badaunicoleta/Single-Stage_Industrial_Gearbox/Project_Documetation.pdf

TECHNICAL UNIVERSITY OF CLUJ-NAPOCA

FACULTY OF AUTOMOTIVE, MECHATRONICS AND MECHANICAL ENGINEERING

DEPARTMENT OF MECHATRONICS AND MACHINE DYNAMICS

# SEMESTER PROJECT

## SINGLE-STAGE INDUSTRIAL GEARBOX

at

## ELEMENTS OF MECHANICAL ENGINEERING

## Sem. II, Year 2020-2021

## Scientific supervisor:

Ciprian-Radu RAD, Ph.D.

## Student Name: Bădău Elena Nicoleta

## Group Number: 30322

Bădău Elena Nicoleta

## Contents

3.1.2 Pitch line velocity (derived from angular velocity and radius of the spoor gear)........11

EME End-of-Semester Project

## Chapter 1. Introduction

### 1.1 Project theme

Design a single stage speed reducer gearbox based on a spur gear (an elementary gearing) that can be used for an industrial mixer. The conceptual design of the mechanical power transmission is presented in Fig. 1.1. It consists of a three-phase induction motor (1), a single stage spur gear reducer (2), two coupling element (3) and the industrial process (4). The material used for the gears is OLC 45 quality carbon steel and for the shafts OL 50 carbon steel. Each student will use their given input data to design the mechanical power transmission.

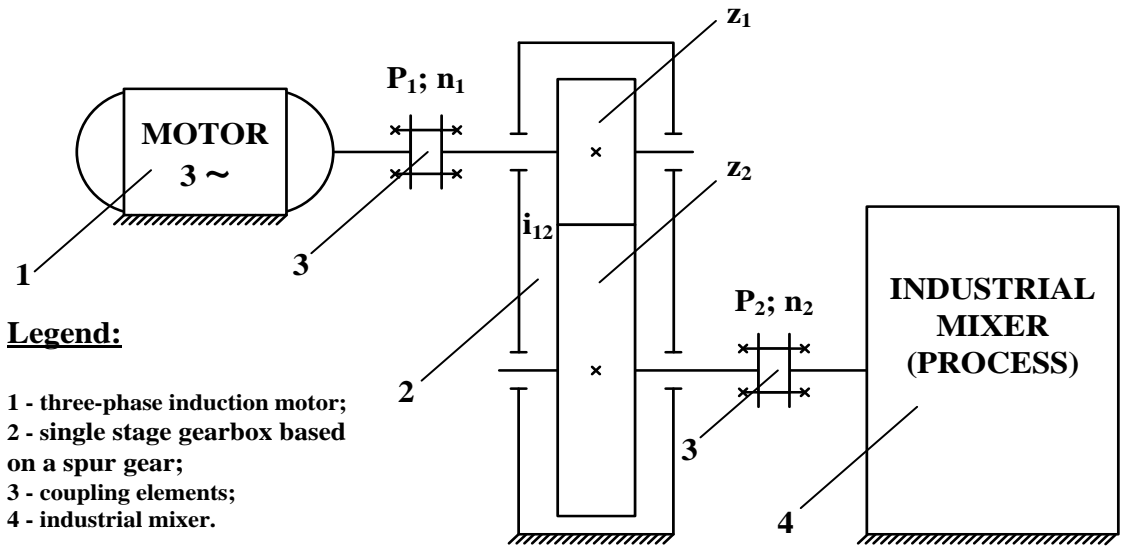
[picture p1: figure]
MOTOR 3 ~; INDUSTRIAL MIXER; (PROCESS); P2; n2 Legend:

Fig. 1.1. Kinematic diagram of the mechanical power transmission.

1 - three-phase induction motor; 2 - single stage gearbox based on a spur gear; 3 - coupling elements; 4 - industrial mixer.

### Input data:

### n = 1 student number

P2

### = 10.4 [kW] – output power

ns

### = 1500 [RPM] – synchronous speed of the motor

i

### 12 = 2.6 (transmission ratio)

z

1 | = 25 (number of teeth of the input gear)
Lh | = 20000 [hours] - number of running hours

### 1.2 Gear speed reducers

Gear speed reducers are mechanical devices used to reduce the speed of an actuator (usually engines) safely and efficiently. They are present in various mechanisms like: cars, bikes (every vehicle which has a gearbox), industrial and household machineries and also they are an object of interest regarding the research in the robotics and mechatronics which almost certainly will, if they have not already, become most important engineering fields of research.
Depending on how they are implemented there are several categories of speed reducers: Parallel axis gear speed reducer, Bevel gear speed reducer, Hypoid speed reducer, Worm speed Reducer and Helical Speed Reducer depending on their structure, on the elements that composed the speed reducer such as: helical gears, spur gears, bevel gears, worm gear and wheels ( for more detail about them check [9], some of them are also detailed in 1.3).
Gear speed reducers are part of transmission systems which are vital in any vehicles powered by engines and they have the role to transmit and adapt the power of the engine to the drive wheels. They are also widely used in municipal waterworks, locks, and flood control systems. They are extremely important and we interact with them very often without even noticing.
The transmissions and speed reducers are devices that obtained the required rotational speed. However, they have one or more important role. That is that they obtain a rotational force (torque) proportional to the deceleration ratio. For example, if we have the rotational speed, that rotational force (torque) will double. This is because the mechanism of changing and decelerating speed uses the principle of leverage (Ex. [9]).

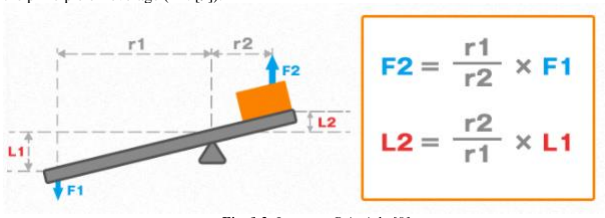
[picture p2: figure]

Fig. 1.2. Leverage Principle [9]

The above figure(see Fig.1.2) shows the principle of leverage. The formula in the above figure demonstrates that a large force called F2 can be obtained with the force of F1 (Ex. [9]), noticing the same procedure for transmission( see Fig.1.3).

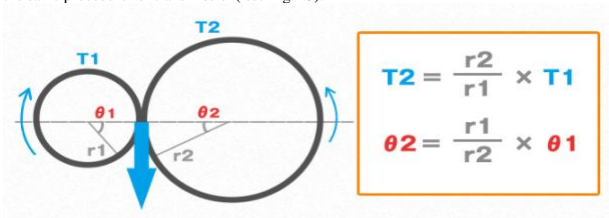
[picture p3: figure]

Fig. 1.3. Rotating Body [9]

Historically, the first ideas of speed reducers and the concept of gearboxes belonged to Muslim polymath named Ismail al-Jazari. In his book called “The Book of Knowledge of Ingenious Mechanical Devices” he talked about arrangements of wheels and mechanical devices, automatic controls, valves and another mechanisms and concepts we study today in engineering. After a long break of 6 centuries, the concept of speed reducer was mentioned again by a British manufacturing and engineering company called Watt & Boulton Engine which designed a gearbox featuring two gears and a rotational speed governor in 1817. Later in 1904, the Sturtevant brothers invented what they called a “horseless carriage gearbox”, which was actually an early automatic power transmission speed reducer.
During the first part of 20 century, the manufacturers were focusing on developing speed reducers for automotive industry, but with the evolution of technology, they become an integrated part of many applications, they are produced in a wide range of sizes and they are constantly improved in terms of: precision, energy efficiency, versatility and many others. For extra details check [10], [11].
The production process is pretty complex and it can be divided in three main parts: making the gears and shafts using cutting and forming processes, creating the gear housings which have to protect the gears against corrosion and another types of contamination and finally the assembling process which brings everything into one functional mechanism which will look like in figure 1.4 (see Fig.1.4). The most common materials used in manufacturing speed reducers are steel (higher or lower quality), plastic and sometimes even wood.

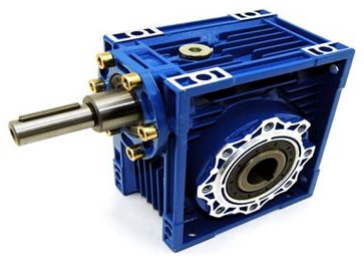
[picture p4: figure]

Fig. 1.4 Gear speed reducer [12]

An important aspect to point out as a conclusion is that, if you are an engineer or maybe you are just a student which has a project to do for university and you want to buy a speed reducer, you have to take a very close look at specifications before sending the order. The most important specifications are the one related to environment, operating conditions and motor type. For more details check [13], where you will find out also what risks are if the specifications and rules made by the manufacturer are not respected.

### 1.3 Power transmission design analysis and justification

Some of the most known and spread mechanical devices worldwide, met in most of the mechanisms that we see every day (cars, industrial machines, household items, robots, and even bikes) are speed reducers and speed amplifiers. When building a speed reducer, the first thing needed is an interdisciplinary team with experience in this domain, a team which is able to analyze and design according to the project requirements a speed reducer which is optimal when considering the following criteria: safety of the people which interact with the mechanism, cost (not too high to be unaffordable but not so low that it can damage the quality of the product by using poor materials), size, reliability and low noise.
In order to be able to quantify a technical solution according to these criteria we need to take a closer look to the possible designs which can be used to implement such a device. Four possible solutions could be: belt drive design, chain drive design, single-stage gear-reducer design and belt drive with single-stage gear-reducer design (for a closer look to technical drawings and performances of each design check [8]) .
The design chosen for our device is single-stage gear-reducer because it has some important features like the high level of safety for operators, the rotating components being enclosed. Another important advantage is the high reliability due to the fact that precision metallic parts are used in a sealed housing(to prevent the contaminating of the metal), belts and chains are also good but they are usually more expensive and their design may also include more moving parts which is seen as a possible risk of failure. The maintenance cost and size are expected to be reduced because of design’s relative simple implementation.
Another possible alternative could be the belt drive with single-stage gear-reducer design because using it we could provide a variable speed operation which could be useful for our application (industrial mixer). Varying the speed of the mixer is possible by using different belt drive ratio. Nevertheless, we can vary speed using our single-stage gear-reducer too, by using a variable speed electric drive motor.
Having the design, we need to focus on what type of gear-type reducer to use. Here are some possible types we can use (for more details check [8]):
Single-reduction spur gears, with high efficiency (> 95%), only radial loads are met so the selection of bearings is significantly simplified and spur gears are relatively cheap to produce. Also shafts position would be parallel, easy to align with the motor and the drive shaft for the mixer.
Single-reduction helical gears, similar with single-reduction spur gears which come to some advantages like smaller size of the mechanism and also some disadvantages like the apparition of axial thrust loads which will cause changes in bearings selection and in housing mechanism. Bevel gears, more difficult to design and assemble.
Worm and wormgear drive present many disadvantages like: lower efficiency, heat generation and the need of a stronger engine.
Considering all these facts, the final decision is single-reduction spur gear reducer design because it works well for our industrial mixer application and the costs are likely to be the lowest.

## Chapter 2. Selecting the Actuator

### 2.1 Selecting the AC motor

### 2.1.1 Synchronous speed calculation

ns =

60×f
p
[RPM] ns = 1500[RPM] | (1)

where:
f = motor supply’s frequency in hertz p = number of pairs of magnetic poles

### 2.1.2 Calculate the slip

s =

ns−nn
ns

=

1500−1440
1500
= 0,04 = 4% = slip | (2)
wℎere s − slip, ns − syncℎronous speed [RPM], nn − rotor nominal speed [RPM] nn < ns

### 2.1.3 Calculate the required motor power [kW] = Pm (needed to transmit P2)

Actuator power
Pm =

P2
η

[kW] =

10.4
0.93
= 11.18[kW], P2 = 10.4[kW] | (3)
wℎere Pm − required motor power [kW] P2 − output power [kW]
η − mecℎanical transmission efficiency

Mechanical transmission efficiency η = ηg × ηb

2 × ηl
= 0.96 × (0.99)
2 × 0.99 = 0.93 − Mecℎanical transmission efficiency | (4)
wℎere ηg − spur gear efficiency = 0.96 ÷ 0.98
ηb − one pair of bearings efficiency = 0.99 ÷ 0.995 ηl − lubrication efficiency = 0.99

! The systems which use spur gears are efficient (η > 0.9)

### 2.1.4 The required values – > The AC motor values (we choose the right engine Pm < Pn)

Pm = 11.18[kW] ns = 1500[RPM] => Pn = 15[kW] nn = 1440[RPM] | (5)

I choose the ASU 160L-4 AC motor with the following properties:
Pn = 15 kW − nominal power of tℎe motor
nn = 1440 − rotor nominal speed[RPM] < ns = 1500[RPM]
η = 0,90 = 90% − mecℎanical transmission efficiency

### 2.1.5 The AC engine dimensions

(see Fig.2.1)

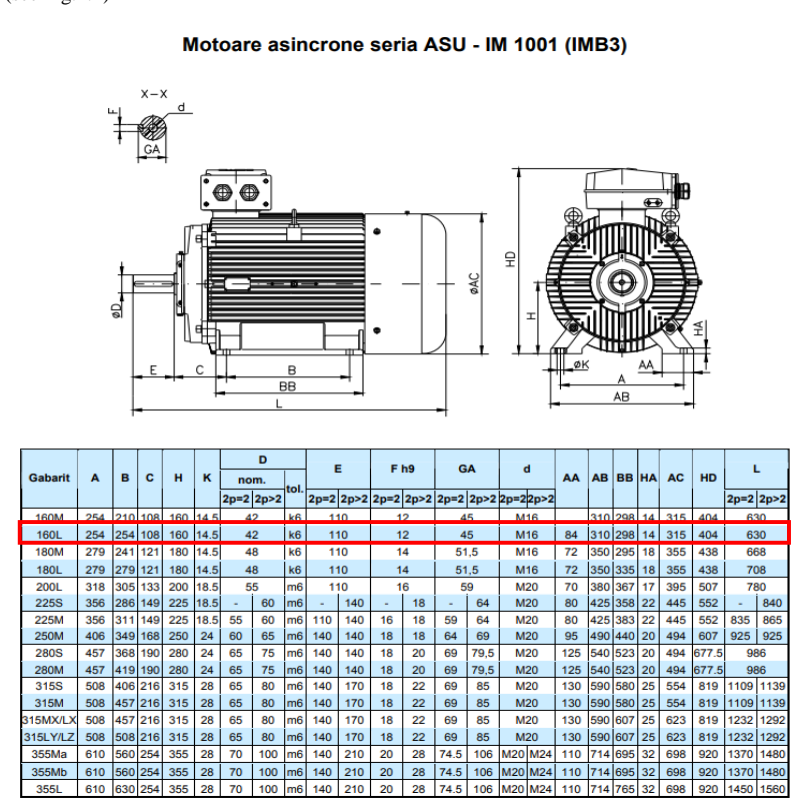
[picture p5: figure]

Fig. 2.1.ASU 160L-4 AC motor dimensions [1]

### 2.2 Power transmission kinematics

### 2.2.1 Determining the number of teeth of the output gear

z2 = i12 × z1 = 2.6 × 25 = 65 − number of teetℎ for tℎe second gear(output gear) (6) wℎere i12 − transmission ratio
z1 − number of teetℎ for tℎe first gear(input gear)
−if z2 is a wℎole number u12 = i12 = 2.6 − transmission ratio
−tℎerefore,tℎe real transmission ratio u12 witℎ tℎe new z2 value can be calculated as(Ex.[2]): u12 =

z2
z1

=

65
25
= 2.6 | (7)
−in tℎis situation tℎe following condition must be meet(Ex.[2]): −2.5% ≤

u12−i12
i12

≤ +2.5% → εu12 = ±2.5% is ok, because u12will be used furtℎer! (8)

### 2.2.2 The Input/Output shaft speed

n1 = nn

[RPM] => n1 = 1440[RPM] → Input (engine speed) | (9)
n2 =

n1
i12

=

1440
2.6

[RPM] = 553.84[RPM] → Output , wℎere i12 − transmission ratio (10)

### 2.2.3 Power transmitted by input shaft

P1 = Pm[kW] → P1 = 11.18[kW] − Power transmitted by sℎaft 1(engine power) (11)

### 2.2.4 The Input/Output shaft Torque

T1 = 95500 ×

P1
n1
= 741.45[daN ∗ cm] | (12)

T2 = 95500 ×

P2
n2
= 1793.29[daN ∗ cm] | (13)

## Chapter 3. Spur Gear Design

### 3.1 Gear tooth strength analysis and verification

### 3.1.1 Strategy

Size the spur gears according to contact stress and then check if the dimensions obtained respects the bending stress conditions too. We will use as material OLC45 high quality steel.

### 3.1.2 Pitch line velocity (derived from angular velocity and radius of the spoor gear)

Pinion peripheral speed or pitch line velocity is associated with angular velocity and radius of the spoor gear.

v = 0.1 × √n1
2 ×

P1
u12

4
= 5.87[m⁄s] | (14)
wℎere P1 = 11.18 × 1.34 = 14.98 HP(HorsePower) | (15)
P1 − transmitted power in ℎorse power [HP] (1kW = 1.34HP)
n1 − Input (engine speed)
u12 − transmission ratio

### 3.1.3 Equivalent load

k = kc × kd = 1.2 → Load factor,
wℎere: kc − load distribution factor, kc = 1 ÷ 1.22
kd − load dynamic factor, kd = 1.2 | (16)

The dynamic load factor was chosen considering: precision class, angular velocity, tooth shape and Hardness Brinell using the catalog from [3] table 9.2.

We use OLC45 with NB=197 ≤350(HB-Hardness Brinell)

### 3.1.4 Equivalent torque

Te1 = k × T1 = 889.74[daN ∗ cm] | (17)

### 3.1.5 Contact stress (dimensioning central/axial distance A)

ψA =

A
B

= 0.4 (medium speed reducer),
ψA − axial coefficient of tℎe gear, ψA = 0.3 ÷ 0.6 | (18)

σak = 26 × HB = 26 × 197 = 5122[daN/cm²
] (for OLC 45) | (19)
wℎere αak − allowable contact stress
HB − Hardness Brinell according to table from [3]table 9.4.

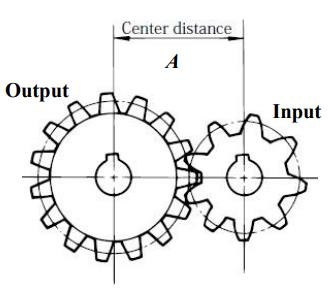
[picture p6: figure]

Fig. 3.1. Axial distance A [3]

Axial distance A(see Fig. 3.1) influences directly the contact stress, using α(pressure angle) = 20°
(see Fig.3.2)
Amin = (u12 + 1) × √
Te1
ψA×u12×sin2α

× (

865

σak

)

3 | 2
[cm] = 10.76[cm] = 107.6[mm] | (20)

α = 20°
Fig. 3.2. Tooth Shape [3]

Aw(standardized) = 108[mm] cℎoosing a rounded value > Amin

### 3.1.6 Circular pitch module(m)

- the distance between 2 successive teeth (must be equal for both spur gears)

z1 = 25 → number of teetℎ for tℎe first gear
z2 = z1 × i12 = 25 × 2.6 = 65 teetℎ
→ number of teetℎ for tℎe second gear (using relation (6))

mmin =

2Aw
z1+z2

cosα
cosα0
[mm], wℎere α0 = 20° → mmin = 2.4[mm] | (21)

m ≥ mmin
m(standardized) = 2.5 mm → A cℎanges!

A =

m×(z1+z2)
2

=

2.5×(25+65)
2
= 112.5[mm] → Final axial distance | (22)

### 3.1.7 Modular coefficient of the gear

ψm =

A×ψA
m
= 18 ε(8, 40), wℎere ψA = 0.4 − axial coefficient of tℎe gear | (23)

### 3.1.8 Bending stress (verification)

{
σ =

2Te1
π×m³×z1×ψm×Cf×cosα0

≤ σai [

daN
cm²

] → σ =

2×889.74
3.14×(0.25)³×25×18×0.1355×0.94

= 661.51 [

daN
cm²

]

mb = √
0.68×Te1
z1×ψm×Cf×σai

3

≤ m [mm] → mb = √
0.68×889.74
25×18×0.1355×1327.16

3
= 0.19[cm] ≤ m = 0.25[cm]

(24)

### 3.1.9 Allowable bending stress

σai =

σ0
kσ×C

=

4300
1.8×1.8

= 1327.16 [

daN
cm²
] | (25)

wℎere kσ − stress concentration coefficient, kσ = 1.2 ÷ 2 C − safety coefficient, C = 1.5 ÷ 2

For additional information check [3] table 4.1.
σ ≤ σai → Verification successful!

mb ≤ m → Verification successful!

### 3.2 Final geometrical elements of the gears

### 3.2.1 Geometrical elements of the gears

The diameters of pitch circles
Dd1 = m × z1 = 2.5 × 25 = 62.5 [mm] | (26)
Dd2 = m × z2 = 2.5 × 65 = 162.5 [mm] | (27)

The diameters of outside circles
De1 = 2Re1 = m(z1 + 2 × f0
) = 2.5(25 + 2) = 2.5 × 27 = 67.5[mm] | (28)
De2 = 2Re2 = m(z2 + 2 × f0
) = 2.5(65 + 2) = 2.5 × 67 = 167.5[mm] | (29)

Whole depth
ℎ = m(2f0 + ω0
) = 2,5(2 + 0.25) = 2.5 × 2.25 = 5.62[mm] | (30)

The diameters of root circles Di1 = 2Ri1 = m(z1 − 2f0 − 2ω0

) = 2.5(25 − 2 − 2 × 0.25) = 56.25[mm] | (31)
Di2 = 2Ri2 = m(z2 − 2f0 − 2ω0
) = 2.5(65 − 2 − 2 × 0.25) = 156.25[mm] | (32)

wℎere f0 = 1 − reference ℎead ℎeigℎt, ω0 = 0.25 − reference foot ℎeigℎt

Gear face width
B = A × ψA = 45[mm] | (33)

Output gear (round up the obtained value)
B2 = A × ψA = 45[mm] | (34)

Input gear (round up the obtained value)
B1 = B2 + m = 47.5[mm] | (35)

### 3.2.2 Contact ratio

The radii of the base circles of the two gears Rb1 = Rd1

cosα0 =

m×z1
2
cosα0 = 29.37[mm] | (36)
Rb2 = Rd2

cosα0 =

m×z2
2
cosα0 = 76.37[mm] | (37)

ε =

√Re1
2 −Rb1

2 +√Re2
2 −Rb2

2 −A×sinα

π×m×cosα0

= 1.72 > 1.2 → works OK! | (38)

### 3.2.3 Span measurement

For z1 = 25 → n1 = 3(number of teetℎ between 18 − 26) N1 = z1 ×

α0
180° + 0.5 = 3.27 | (39)

Ln1 = m[(N1 − 0.5)π + z1inv α0

]cos α0 = 21.24 [mm] | (40)

For z2 = 65 → n2 = 8(number of teetℎ between 72 − 80)

N2 = z2 ×

α0
180° + 0.5 = 7.72 | (41)
Ln2 = m[(N2 − 0.5)π + z2inv α0
]cos α0 = 55.41 [mm] | (42)

wℎere inv α0 = inv 20° = 0.014904

## Chapter 4. Output Shaft Design

Shafts are subjected to torsion and bending stress! (see Fig. 4.1)

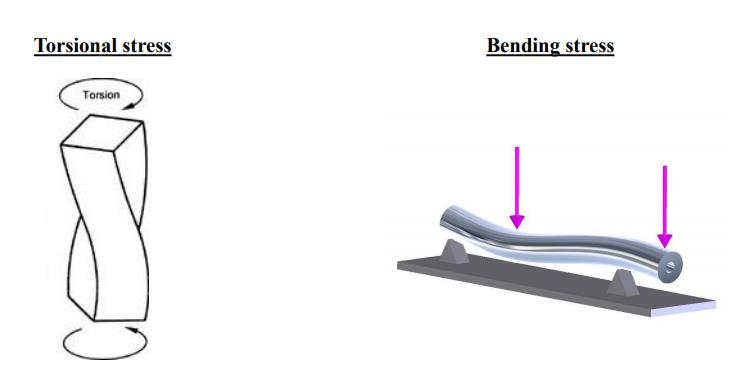
[picture p7: figure]

Fig. 4.1. Torsion and Bending stress [4]

### 4.1 Pre-dimensioning

### 4.1.1 Preliminary diameter

Preliminary diameter dp is determined at torsional stress because at this point the length of the shaft is not known.(Ex.[4])
dp min = √
16×T2
π×τat

3
[cm] = 3.93[cm] = 39.3[mm] | (43)

wℎere τat = 120 ÷ 250[daN/cm² ] − Torsional sℎear stress

dp ≥ dpmin

→ dp = 40[mm] − preliminary diameter | (44)

### 4.1.2 Preliminary length of the output shaft

b = B2

[mm] = 45[mm](face widtℎ) − tℎe widtℎ of tℎe second (output)gear | (45)
l = b + 2l1 + l2 = 45 + 20 + 20 = 85[mm] | (46)
wℎere l1 = 10[mm] l2 = 0.5 × dp = 20[mm]
particular lengtℎs wℎicℎ must be considered. For more details cℎeck [4]

### 4.1.3 Forces acting on a spur gear mesh

η ≈ 1 (Mechanical transmission efficiency)

Ft1 ≈ Ft2 (Tangential forces)

Fr1 ≈ Fr2 (Radial forces)

The spur gears mechanism is efficient in transmitting tangential and radial forces.
The forces occur between 2 teeth on a specific line as can be seen in the picture. (see Fig.4.2)

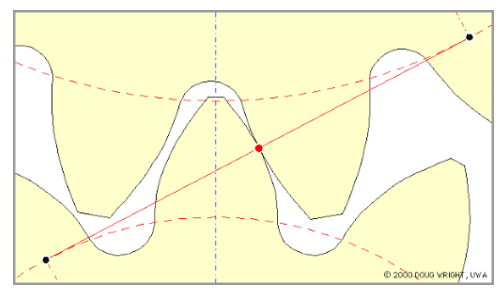
[picture p8: figure]

Fig. 4.2. Where forces act [4]

### 4.1.4 Tangential force (acts on vertical plane, on point number 6)

Dd2 = m × z2 = 2.5 × 65 = 162.5 [mm] − pitch diameter (using relation (25))

Ft2 =

2T2

Dd2

[daN] = 220.71[daN] | (47)

### 4.1.5 Radial force (acts on horizontal plane)

Fr2 = Ft2

tanα0

[daN] = 220.71 × 0.363 = 80.11[daN] | (48)
wℎere α0 = 20°

### 4.2 Shaft loading diagram

### (see Fig.4.3)

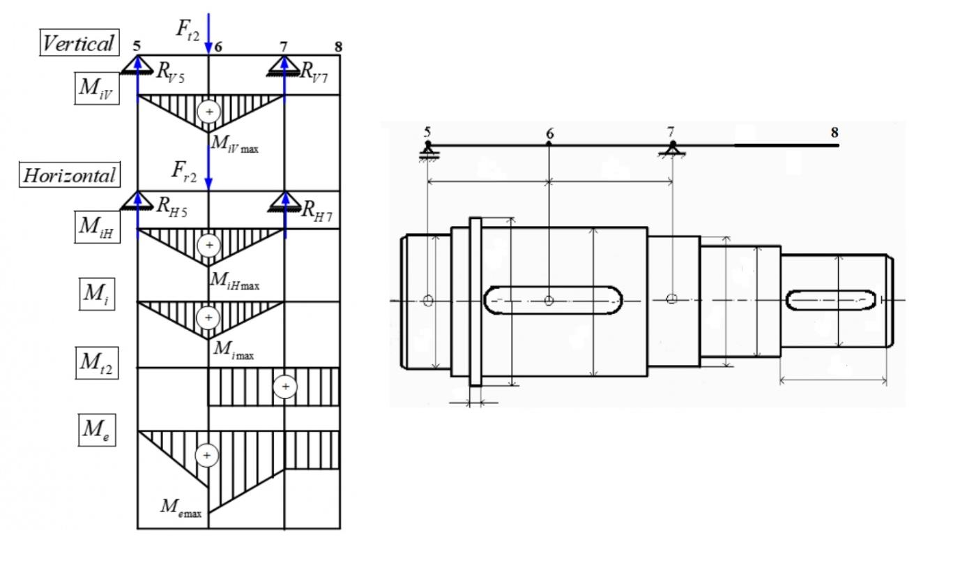
[picture p9: figure]

Fig. 4.3. Shaft loading diagram [4]

### 4.2.1 Reaction forces and bending moments in both planes

Vertical plane

RV5 = RV7 =

Ft2
2

[daN] =

220.71
2

= 110.35 [daN] −reaction forces on support points (5,7) (49)

MiVmax =

1
4

∗ Ft2 ∗ l [daN ∗ cm] = 234.49[daN ∗ cm] − maximum momentum produced by
the tangential force on vertical plane. | (50)

Horizontal plane

RH5 = RH7 =

Fr2
2

[daN] =

80.11
2

= 40.05[daN] −reaction forces on support points (5,7) (51)

MiHmax =

1
4

∗ Fr2 ∗ l [daN ∗ cm] = 170.23[daN ∗ cm] −maximum momentum produced by
the radial force on horizontal plane. | (52)

Resulting reaction forces (algebraic sum of the forces acting on horizontal/vertical plane)
R5 = R7 = √RV5
2 + RH5

2
[daN] = √13781.12 = 117.39[daN]

Resulting bending momentum (algebraic sum of the momentums acting on horizontal/vertical plane)

Mimax = √MiVmax
2 + MiHmax

2
[daN ∗ cm] = 289.76 [daN ∗ cm] | (53)

### 4.2.2 Equivalent bending moment

Memax = √Mimax
2 + (αT2
)
2 [daN ∗ cm] = 1114.3[daN ∗ cm] | (54)

wℎere T2 = 1793.29[daN ∗ cm] − output sℎaft torque (using relation (13))

α =

σaiΙΙΙ

σaiΙΙ

= 0.6 (OL50 build material) → Build material coefficient σaiΙΙΙ = 450 [daN/cm²

] σaiΙΙ = 750 [daN/cm²
]

### 4.2.3 Required diameter in critical section

dmin = √
32∗Memax

π∗σaiΙΙΙ

3
[cm] = 2.93[cm] | (55)

! Because a key will be used to assembly the gear with the shaft, the value of dmin must be increased by 4% (Ex.[4])

dmin = dmin + 4% ∗ dmin = 30.47 mm, round up tℎe result to final d = 32 mm (56)
d ≥ dmin

### 4.3 Final geometry of the shaft

(see Fig.4.4)

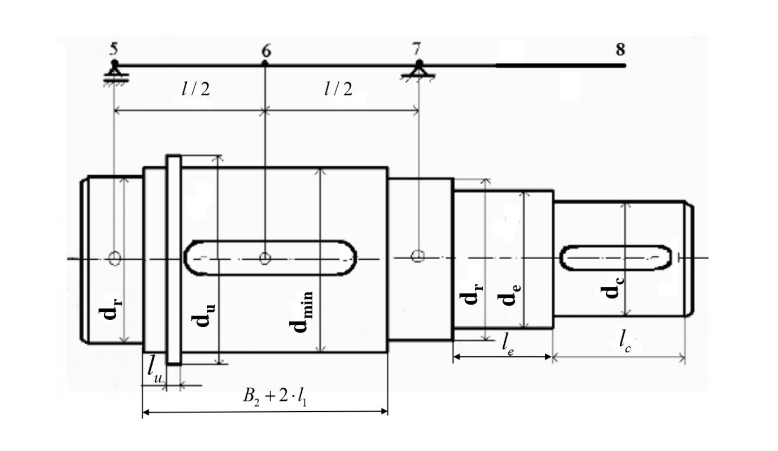
[picture p10: figure]

Fig. 4.4. Final geometry of the shaft [4]

Diameters in other points on the shaft

du > d > dr ≥ de > dc
du − is tℎe sℎoulder diameter (to be cℎosen)
d − is tℎe diameter wℎere tℎe output gear will be mounted(calculated before)
dr − is tℎe diameter of tℎe sℎaft wℎere tℎe bearings will be mounted (to be cℎosen) de − is tℎe diameter of tℎe sℎaft wℎere tℎe seal will be mounted(to be cℎosen)
dc − is the diameter of the end of the shaft; end of the shaft will be connected
to the process, in this case the industrial mixer through a coupling element (to be chosen). (Ex.[4])

### 4.3.1 Diameter of the end shaft (point 8)

dc min = √
16×T2
π×τat

3
[cm] = 2.33[cm] = 23.3[mm] | (57)

Torsional shear stress for OL 50 τat = (0.6 ÷ 0.65)σall [

daN
cm²

] = 0.6 × 1200 = 720 [

daN
cm²
] | (58)

σall = 1200 [

daN
cm²

]

wℎere σall

is tℎe allowable stress at traction for material OL 50, pulsating cycle, case II. (Ex.[4])

Choose a final value of diameter dc and then the length lc
from the next slide(Ex.[4])
dc ≥ dc min → dc = 24[mm] | (59)

### 4.3.2 Length of the end of the shaft

if dc = 24[mm] → lc = 50[mm] | (60)

### 4.3.3 Seal diameter

de = dc + (3. .5)mm = 24 + 3 = 27[mm] | (61)
le = 0.5 × dp = 0.5 × 40 = 20[mm] | (62)
wℎere dp = 40[mm] | (using relation (44))

### 4.3.4 Bearings diameter

dr = de + (3. .5)mm = 27 + 3 = 30[mm] | (63)

### 4.3.5 Shoulder diameter and length

du = d + (3. .5)mm = 32 + 3 = 35[mm] | (64)
lu = 4[mm] | (65)

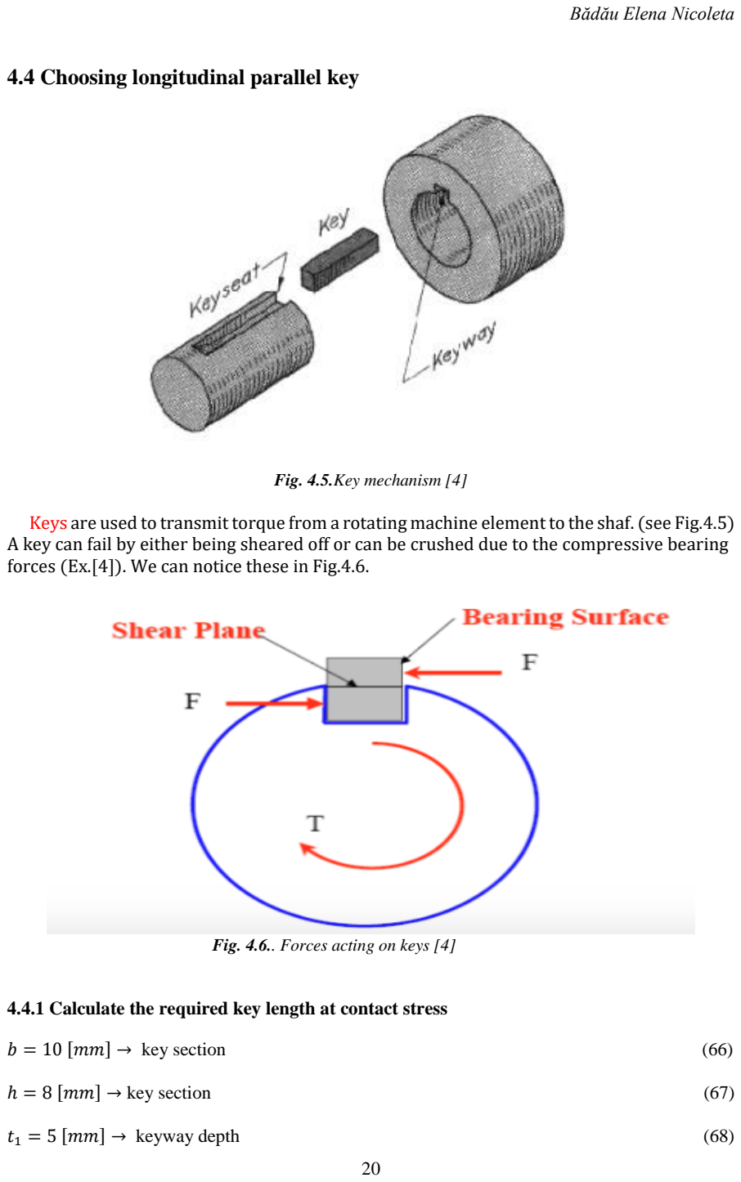
[picture p11: page 20]

### 4.4 Choosing longitudinal parallel key

Fig. 4.5.Key mechanism [4]

Keys are used to transmit torque from a rotating machine element to the shaf. (see Fig.4.5) A key can fail by either being sheared off or can be crushed due to the compressive bearing forces (Ex.[4]). We can notice these in Fig.4.6.

Fig. 4.6.. Forces acting on keys [4]

### 4.4.1 Calculate the required key length at contact stress

b = 10 [mm] → key section | (66)
ℎ = 8 [mm] → key section | (67)
t1 = 5 [mm] → keyway depth | (68)

t2 = 3.3 [mm] → keyway depth | (69)

We can see b, ℎ, t1,t2 in Fig.4.7.

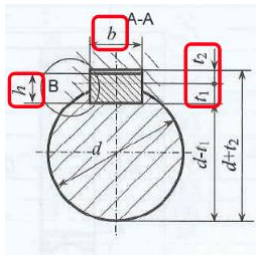
[picture p12: figure]

Fig.4.7. Key dimensions [4]

lmin =

4T2
ℎ×d×pa
[cm] = 3.5 [cm] = 35 mm − key minimum length | (70)

where pa = 800 [

daN
cm²

] −contact pressure

! The final length of the key must be correlated with the width B2 of the output gear. (Ex.[4]) lp = 0.8 × B2 = 0.8 × 45 = 36[mm] ≥ lmin = 35[mm] and is between (22,110)
(accepted lengths for 30 < d ≤ 38). I will use the standardized value lpa = 40[mm] | (71)
wℎere lpa ≥ lp

### 4.4.2 Verification for shear stress (already dimensioned for contact pressure)

τf =

2T2
b×d×lpa

< τaf [

daN
cm²

] → τf =

2×1793.29
1×3.2×4

= 280.2[daN/cm²
] < τaf | (72)
τaf = 960[daN/cm²
] − OL50

wℎere b = 1[cm](13), d = 3.2[cm](66), lpa = 4[cm](56), T2 = 1793.29[daN ∗ cm](64)

### 4.5 Verification of shaft deflection and critical speed

### 4.5.1 Deflection in vertical plane

fV =

Ft2∗l

3

48∗E∗I

[cm] = 261.60 × 10⁻⁶
[cm] | (73)

where:
E = 2.1 ∗ 10⁶

[daN/cm²
]
I = π ∗

d

4

64

[cm] = 5.14 [cm] | (74)
l=8.5 [cm] − the shaft length | (using relation (42))

### 4.5.2 Deflection in horizontal plane

fH =

Fr2∗l

3

48∗E∗I

[cm] = 94.95 × 10⁻⁶
[cm] | (75)

where:
E = 2.1 ∗ 10⁶

[daN/cm²
]
I = π ∗

d

4

64

[cm] = 5.14 [cm] | (using relation (67))
l=8.5 [cm] − the shaft length | (using relation (42))

### 4.5.3 Final deflection and admitted deflection

f = √fV
2 + fH

2 < fadm [cm] → f = 278.29 × 10⁻⁶ [cm] = 0.00027829[cm] < fadm [cm] (76)
fadm = 5 × 10⁻³ × m = 3 × 10⁻⁴ × l [cm] = 0.00255[cm] | (77)

### 4.5.4 Weight of the output gear + static deflection (check vibrations)

{
G = γ × V = γ ×

π×Dd

2

4

× B2

[daN] = 7.2[daN] − weight of the output gear

γ = 7.8 × 10⁻³

[

daN
cm³

]

(78)

### 4.5.5 Static deflection

{

fst =

G∗l

3

48∗E∗I

[cm] =

7.2×(8.5)

3
48×2.1×10⁶×5.14

= 8.53 × 10⁻³
[cm]

E = 2.1 × 10⁶

[

daN
cm²

]

I = π ×

d

4

64

[cm] = 5.14[cm]

(79)

### 4.5.6 Critical speed

ncr =

30
π

∗ √
g

fst

[RPM] = 102 376 [RPM] | (80)

g = 981 [

cm
s

2

] − gravitational acceleration

n2 = 553.84[RPM] < ncr (from relation (7))

## Chapter 5. Rolling Bearing Selection

### 5.1 Calculate dynamic basic bearing load rating C

### 5.1.1 Introduction – General facts

The ball bearings place in our design (see Fig.5.1):

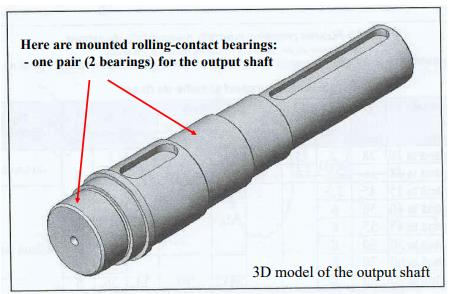
[picture p13: figure]

Fig. 5.1. Bearings location [5]

Important features:

Bearings are not designed, they are chosen accordingly to the project that you are working on from catalogues.

Another important feature of bearings is that they are consumables and are replaced periodically.

They need to be changed in pairs, both at the same time, in order to have the same characteristics and the same performances at a certain moment of time.

Considering our project, we will choose bearings which are built to support purely radial load (type A Fig. 5.2) because all our forces are acting perpendicular on the shaft.

Type of rolling-contact bearings:

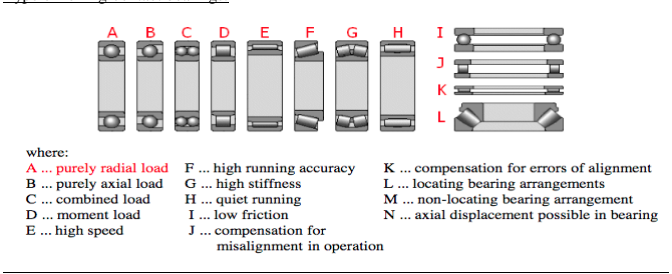
[picture p14: figure]

Fig. 5.2. Bearings types [6]

Cause of early bearings failure (see Fig. 5.3):

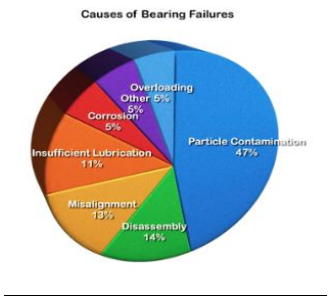
[picture p15: figure]

Fig. 5.3. Bearings location [6]

### 5.1.2 Fundamental calculation

We will use: Life’s equation (Lundberg & Palmgren) where:

C - dynamic basic bearing load rating [daN], calculated so that the bearings can support the load C for 1 million rotations.

L - the basic life measurable in millions of rotations

L =

60×n2×Lℎ
10⁶
[milions of rotations] = 664.6 [milions of rotations] | (81)

L = (

C
F

)

p
| (82)

where: Lℎ = 20000 [hours] − number of running hours (check page 4) n2 = 553.84[RPM] −rotational speed [RPM] (check relation (10)) F= bearing load [daN]

### 5.1.3 Equivalent bearing load Fe

Considering the reaction forces which occur on the support points 5 and 7 (check figure 5.4), we can compute the resulting total radial force Fr with the following formula:

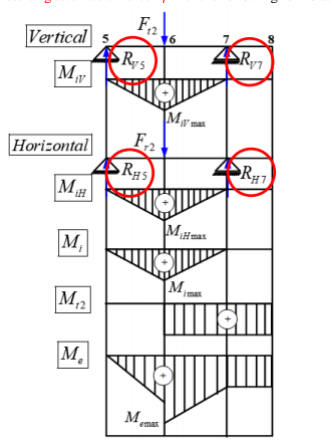
[picture p16: figure]

Fig.5.4. Shaft loading diagram [5]

Fe = Fr = R5 = R7 = √RV5
2 + RH5

2
[daN] = 117.39 [daN] | (83)
RV5 = 110.35[daN](49), RH5 = 40.05[daN](51) where Fe − equivalent bearing load

### 5.1.4 Dynamic basic bearing load rating (Cmin)

(

Cmin
Fe

) = L
0.33
, using (64) and p = 0.33 − exponent factor

Cmin = Fe ∗ L

0.33 = 1001.33 [daN] = 10.01 [kN] | (84)

### 5.1.5 Bearing selection from the Table 5.1

The selection will be done taking into consideration Cmin = 10.01[kN] (84),
dr = 30 [mm] (63) (check 4.3 Final geometry of the shaft) and the following table:

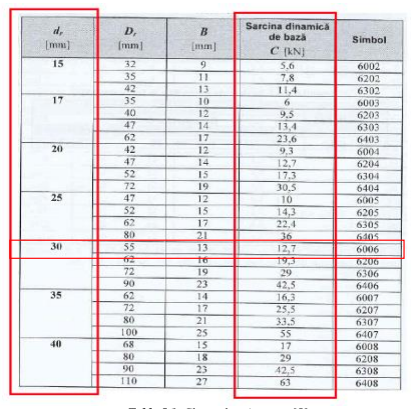
[picture p17: figure]

Table 5.1. Choose bearing type [5]

In conclusion the symbol of our bearings is: 6006 with C=12.7[kN] ≥ Cmin = 10. 01[kN] (from the Table 5.1).

### 5.2 Bearing selection from SKF catalogue

From SKF catalogue we have selected a bearing of W 6006 (from Table 5.2)

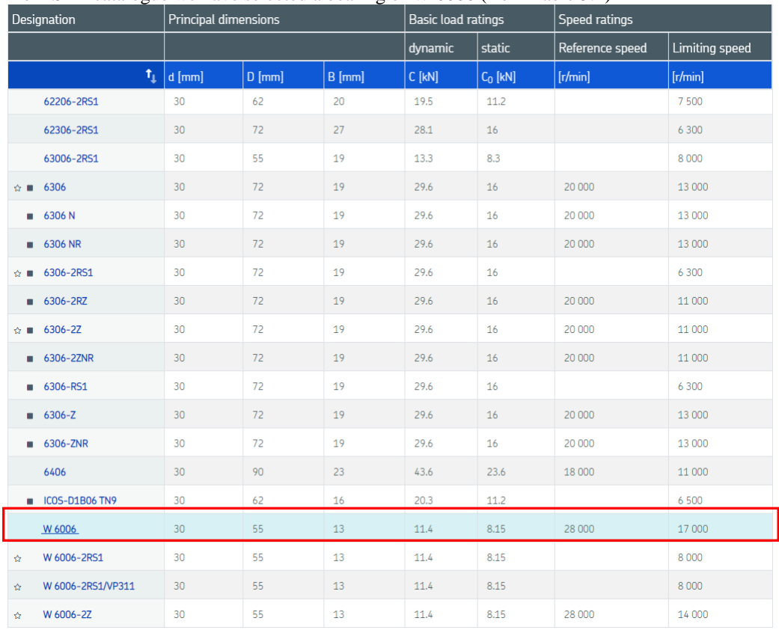
[picture p18: figure]

Table 5.2. Choose bearing type from SKF catalogue [7]

### 5.3 Technical specification of the selected bearing

Its basic load rating (dynamic) C is 11.4 kN.
Dimensions of the bearings are as follow (see Fig.5.5 and Fig.5.6):

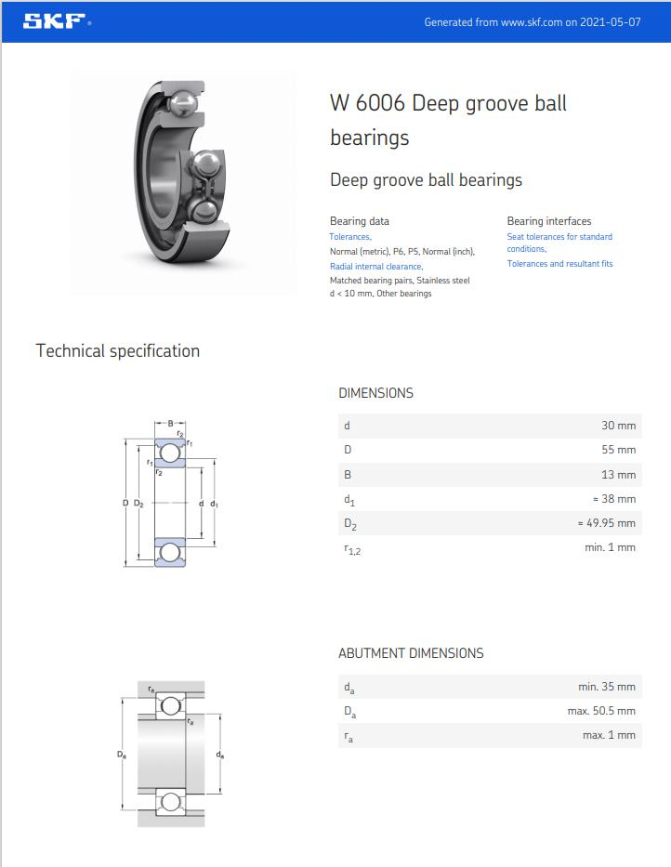
[picture p19: figure]

Fig. 5.5. Bearings W 6006 specifications (1) [7]

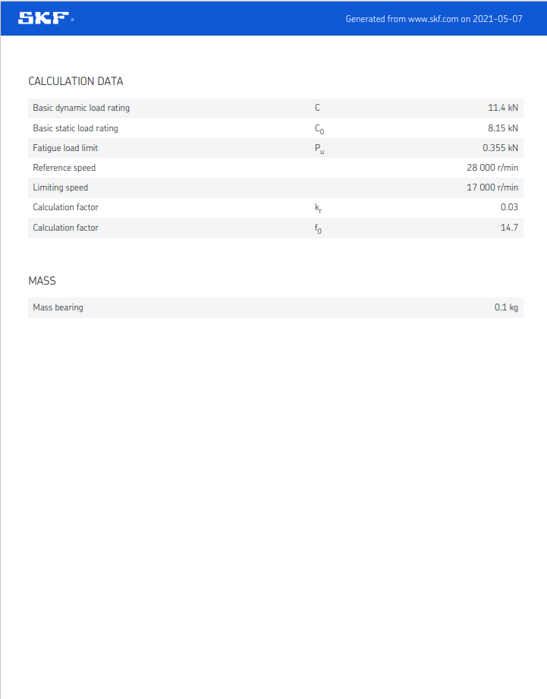
[picture p20: figure]

Fig. 5.6. Bearings W 6006 specifications (2) [7]

## REFERENCES

[1] Rad C., AC motor catalog, Technical University of Cluj-Napoca, Cluj-Napoca, 2021.
[2] Rad C., Elements of Mechanical Engineering Part 1 Seminary 7, Technical University of Cluj-Napoca, Cluj-Napoca, 2021.
[3] Rad C., Elements of Mechanical Engineering Part 2 Seminary 8, Technical University of Cluj-Napoca, Cluj-Napoca, 2021.
[4] Rad C., Elements of Mechanical Engineering Part 3 Seminary 9, Technical University of Cluj-Napoca, Cluj-Napoca, 2021.
[5] Rad C., Elements of Mechanical Engineering Part 4 Seminary 10, Technical University of Cluj-Napoca, Cluj-Napoca, 2021.
[6] Rad C., Elements of Mechanical Engineering Course - C10, Technical University of Cluj-Napoca, Cluj-Napoca, 2021.
[7] SKF.com, Technical specifications of bearings W6006, https://www.skf.com/au/products/rolling-bearings/ball-bearings/deep-groove-ball-bearings#cid-463368 (https://www.skf.com/au/products/rolling-bearings/ball-bearings/deep-groove-ball-bearings#cid-463368)
[8] Rad C., Elements of Mechanical Engisneering – technical solutions, Technical University of Cluj-Napoca, Cluj-Napoca, 2021
[9] What Are Transmissions and Speed Reducers? Their Types and Structures, https://www.mikipulley.co.jp/EN/Products/SpeedChangersAndReducers/about.html
[10] Speed Reducers, https://www.speed-reducers.org
[11] Book of Ingenious Devices, https://en.wikipedia.org/wiki/Book_of_Ingenious_Devices
[12] Worm Gear Speed Reducer, https://www.indiamart.com/proddetail/worm-gear-speed-reducer-5706394712.html (https://www.indiamart.com/proddetail/worm-gear-speed-reducer-5706394712.html)
[13] Select speed reducers to perform reliably, https://www.machinedesign.com/motors-drives/article/21828150/select-speed-reducers-to-perform-reliably (https://www.machinedesign.com/motors-drives/article/21828150/select-speed-reducers-to-perform-reliably)

# ANNEXES

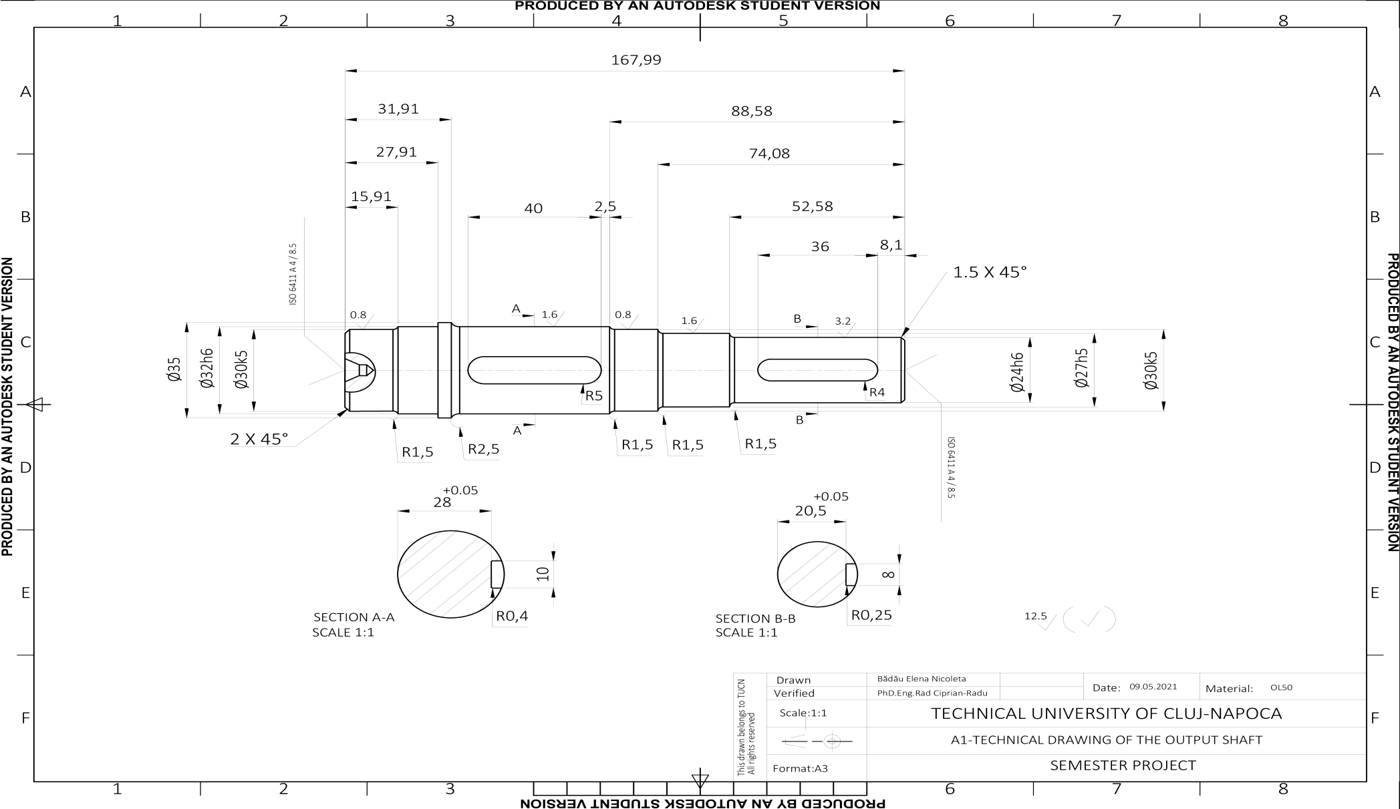
[picture p21: page 32]

32

A1 - Technical drawing of the output shaft
