badaunicoleta/Single-Stage_Industrial_Gearbox/(list of files, cad)

Other CAD files:
OutputShaft.dwg
